IanDeBom/LineFollower/technische tekeningen/mechanisch/readme.md

# mechanische tekening

|bestand|inhoud|
|---|---|
|[SolidworksDrawing_Linefollower.pdf](SolidworksDrawing_Linefollower.pdf)|SolidWorks-tekening van de printomtrek (outline) van de PCB|

De omtrek uit deze tekening is gebruikt als printrand (BoardOutline) van de PCB in EasyEDA Pro.
De vorm is een T: achteraan 66 × 45 mm voor de motoren en de batterij, een smalle nek, en vooraan een sensorbalk van 78 × 20 mm. Totale lengte 100 mm.
