IanDeBom/LineFollower/bill of materials/BOM_Linefollower_1-PCB_PCB_Linefollower_2026-11-09.xlsx

No. | Quantity | Comment | Designator | Footprint | Value | Manufacturer Part | Manufacturer | Supplier Part | Supplier | LCSC Price
1 | 6 | 10uF | C1,C2,C4,C9,C12,C24 | C0805 |  | CL21A106KAYNNNE | SAMSUNG(三星) | C15850 | LCSC
2 | 13 | 100nF | C3,C5,C8,C11,C13,C14,C17,C19,C20,C21,C22,C23,C25 | C0805 |  | CC0805KRX7R9BB104 | YAGEO(国巨) | C49678 | LCSC
3 | 1 | 470uF | C6 | CAP-SMD_BD8.0-L8.3-W8.3-LS9.0-FD_RVT25V470M8X10 |  | RVT25V470M8X10 | JIERR(捷而瑞) | C47023111 | LCSC
4 | 1 | 10nF | C7 | C0805 |  | CL21B103KBANNNC | SAMSUNG(三星) | C1710 | LCSC
5 | 1 | 2.2uF | C10 | C0805 |  | CGA0805X7R225M500MT | HRE(芯声) | C23692980 | LCSC
6 | 2 | 12pF | C15,C16 | C0603 |  | CL10C120JB8NNNC | SAMSUNG(三星) | C38523 | LCSC
7 | 1 | 1uF | C18 | C0805 |  | CSA0805X7R105K500KT | HRE(芯声) | C49420273 | LCSC
8 | 1 | XY-IDC2.54-2*3P-W | CN1 | CONN-TH_XY-IDC2.54-2X3P-W |  | XY-IDC2.54-2*3P-W | XYECONN(辛译) | C53200830 | LCSC
9 | 2 | SS34_C8678 | D1,D2 | SMA_L4.3-W2.6-LS5.2-RD |  | SS34 | MDD(辰达半导体) | C8678 | LCSC
10 | 1 | 0805G (Green) | LED1 | LED0805-R-RD |  | KT-0805G | KENTO | C2297 | LCSC
11 | 1 | AO3400A | Q1 | SOT-23-3_L2.9-W1.3-P1.90-LS2.4-BR |  | AO3400A | AOS | C20917 | LCSC
12 | 2 | 22Ω | R1,R2 | R0805 |  | 0805W8F220JT5E | UNI-ROYAL(厚声) | C17561 | LCSC
13 | 2 | 1kΩ | R3,R20 | R0805 |  | 0805W8F1001T5E | UNI-ROYAL(厚声) | C17513 | LCSC
14 | 12 | 10kΩ | R4,R5,R6,R7,R8,R9,R10,R11,R19,R22,R23,R24 | R0805 |  | 0805W8F1002T5E | UNI-ROYAL(厚声) | C17414 | LCSC
15 | 4 | 150Ω | R12,R13,R14,R15 | R0805 |  | 0805W8F1500T5E | UNI-ROYAL(厚声) | C17471 | LCSC
16 | 1 | 100Ω | R16 | R0805 |  | 0805W8F1000T5E | UNI-ROYAL(厚声) | C17408 | LCSC
17 | 4 | 100kΩ | R17,R18,R25,R26 | R0805 |  | 0805W8F1003T5E | UNI-ROYAL(厚声) | C149504 | LCSC
18 | 1 | 2kΩ | R21 | R0805 |  | 0805W8F2001T5E | UNI-ROYAL(厚声) | C17604 | LCSC
19 | 8 | QRE1113GR | S1,S2,S3,S4,S5,S6,S7,S8 | OPTO-SMD_QRE1113GR |  | QRE1113GR | onsemi(安森美) | C232862 | LCSC
20 | 1 | SMTS-102-C4B-N0 | SW1 | SW-TH_SMTS-102-C4B-N0 |  | SMTS-102-C4B-N0 | YUEN FUNG(源丰) | C48393108 | LCSC
21 | 2 | SKPRAAE010 | SW2,SW3 | SW-SMD_SKPRAAE010 |  | SKPRAAE010 | ALPSALPINE(阿尔卑斯阿尔派) | C127484 | LCSC
22 | 1 | V+ | TP1 | TESTPOINT-TH_BD3.2 |  | TP-橘色测试点 | null | C9900007421 | LCSC
23 | 1 | V- | TP2 | TESTPOINT-TH_BD3.2 |  | TP-橘色测试点 | null | C9900007421 | LCSC
24 | 1 | AOUT1 | TP3 | TESTPOINT-TH_BD3.2 |  | TP-橘色测试点 | null | C9900007421 | LCSC
25 | 1 | AOUT2 | TP4 | TESTPOINT-TH_BD3.2 |  | TP-橘色测试点 | null | C9900007421 | LCSC
26 | 1 | BOUT1 | TP5 | TESTPOINT-TH_BD3.2 |  | TP-橘色测试点 | null | C9900007421 | LCSC
27 | 1 | BOUT2 | TP6 | TESTPOINT-TH_BD3.2 |  | TP-橘色测试点 | null | C9900007421 | LCSC
28 | 1 | PM2.54-1X6PZZ-H8.5 | U1 | HDR-TH_PM2.54-1X6PZZ-H8.5 |  | PM2.54-1x6PZZ-H8.5 | SHOU HAN(首韩) | C54876728 | LCSC
29 | 1 | AMS1117-5.0_C165483 | U3 | SOT-223_L6.5-W3.5-P2.30-LS7.0-BR |  | SK1117-5.0 | SHIKUES(时科) | C165483 | LCSC
30 | 1 | DRV8833PWP | U5 | TSSOP-16_L5.0-W4.4-P0.65-LS6.4-BL-EP |  | DRV8833PWPR | TI(德州仪器) | C50506 | LCSC
31 | 1 | ATMEGA32U4-AU | U7 | QFP-44_L10.0-W10.0-P0.80-LS13.2-BL |  | ATMEGA32U4-AU | MICROCHIP(美国微芯) | C44854 | LCSC
32 | 1 | Micro USB-B 5P-Female-SMT_C40940 | USB1 | MICRO-USB-SMD_5P-P0.65-H-M_MICRO-5P |  | 920-F62A2021S10103 | 精拓金 | C40940 | LCSC
33 | 1 | 16MHz | X2 | CRYSTAL-SMD_4P-L3.2-W2.5-BL |  | X322516MLB4SI | YXC(扬兴晶振) | C13738 | LCSC
