IanDeBom/LineFollower/technische tekeningen/elektronisch/EasyEda_ElektrischSchema_Linefollower.pdf

### GND

### Batterij soldeerpads

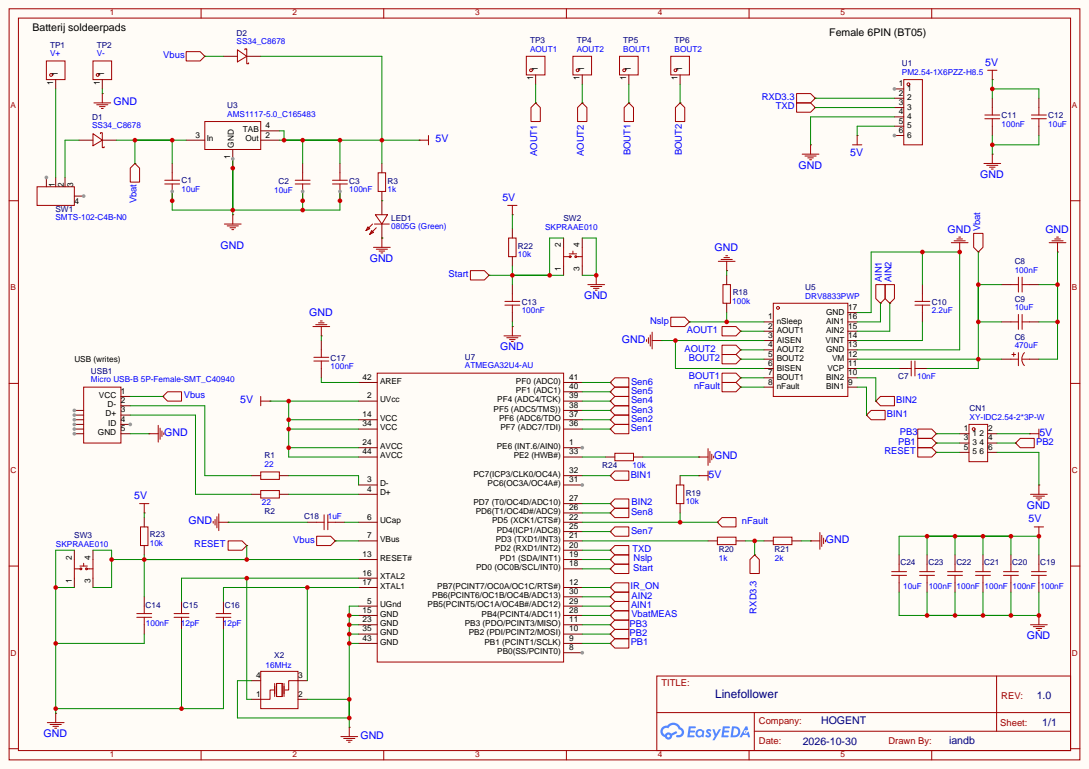
[picture p2: page 1]

AIN1
BIN2 10 VCP 11 VM 12 GND 13 VINT 14 AIN2 15 AIN1 16 GND 17

PB7(PCINT7/OC0A/OC1C/RTS#) 12
PB2 (PDI/PCINT2/MOSI) 10 PB3 (PDO/PCINT3/MISO) 11 PB4(PCINT4/ADC11) 28 PB5(PCINT5/OC1A/OC4B#/ADC12) 29 PB6(PCINT6/OC1B/OC4B/ADC13) 30

GND 5V | GND 5V | GND 5V | GND 5V | GND 5V | GND 5V | GND 5V | GND 5V

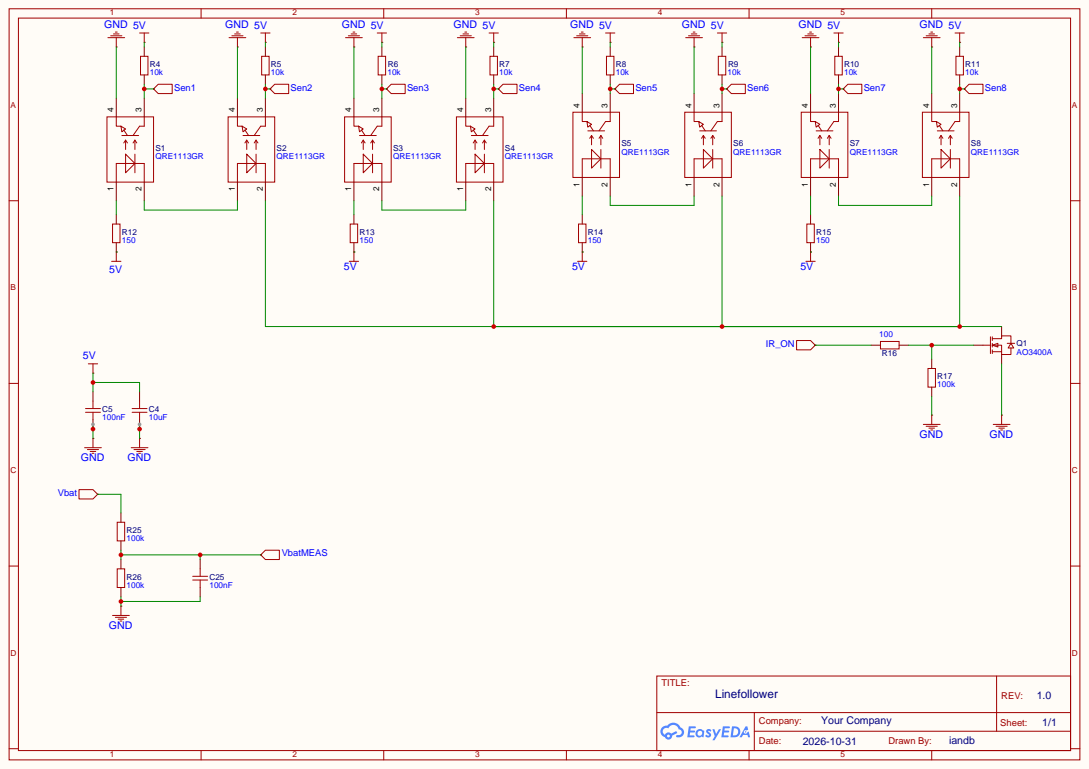
[picture p3: page 2]
