IanDeBom/LineFollower/technische tekeningen/mechanisch/SolidworksDrawing_Linefollower.pdf

D D

6

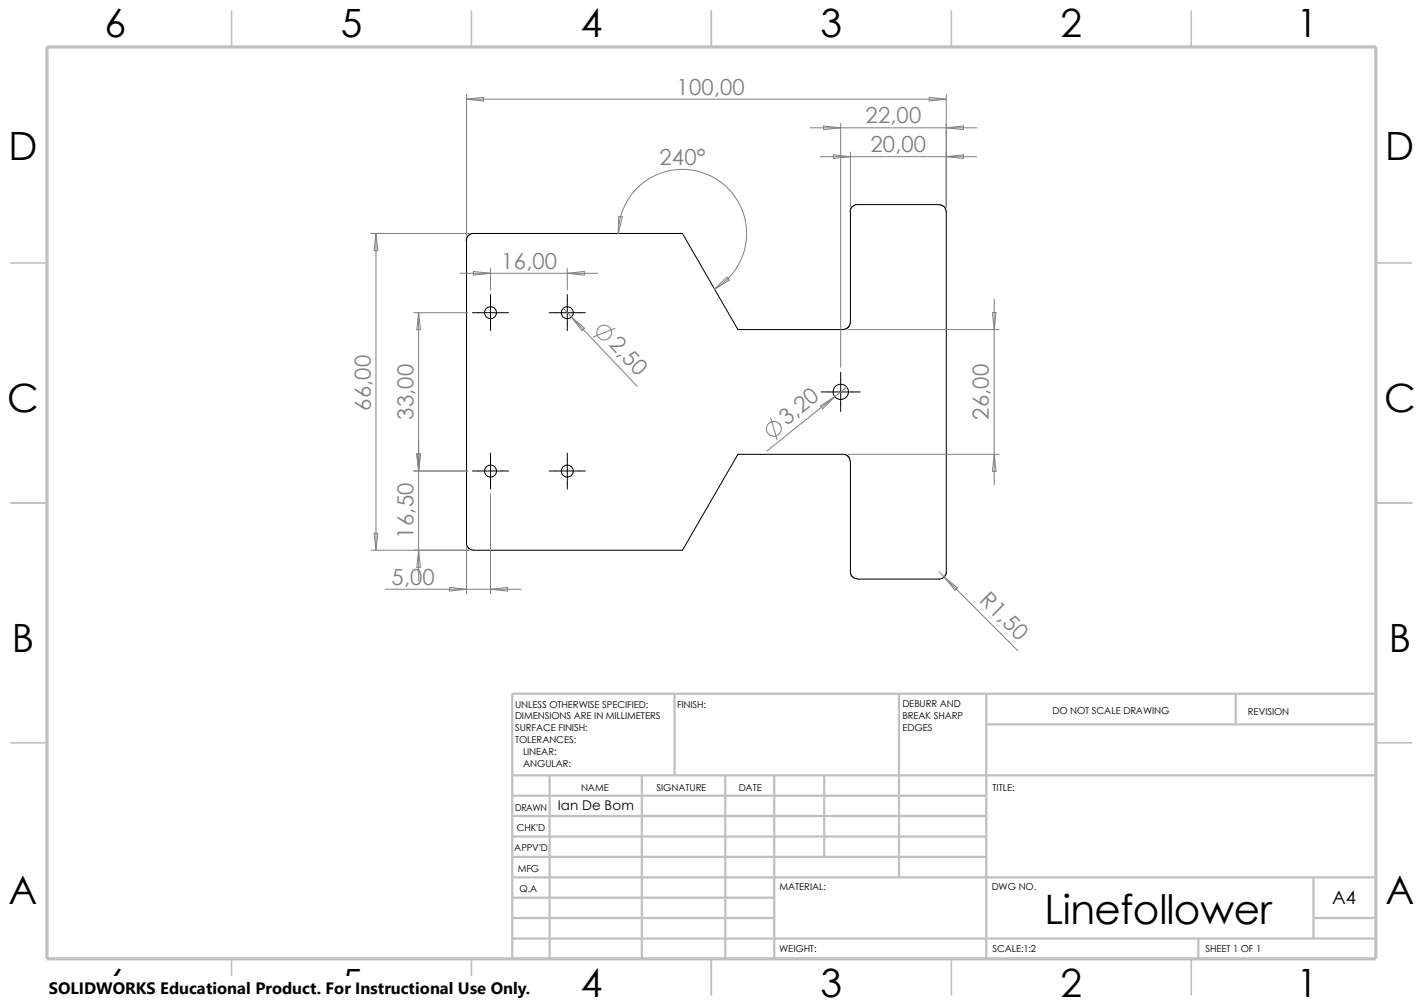
[picture p4: page 1]
SCALE:1:2; SHEET 1 OF 1; WEIGHT:; DO NOT SCALE DRAWING; REVISION; FINISH:; EDGES; DEBURR AND BREAK SHARP

UNLESS OTHERWISE SPECIFIED:
DIMENSIONS ARE IN MILLIMETERS
SURFACE FINISH:
TOLERANCES:
LINEAR:
ANGULAR:

NAME | SIGNATURE | DATE | | | | TITLE:

DRAWN | Ian De Bom

CHK'D
APPV'D

MFG
Q.A | | | | MATERIAL: | DWG NO. Linefollower | A4

SOLIDWORKS Educational Product. For Instructional Use Only.
