IanDeBom/LineFollower/code/basis/programma.ino

#include <Arduino.h>         // basisfuncties Arduino (ATmega328P - Arduino Nano)
#include <EEPROM.h>          // parameters opslaan in eeprom geheugen (ingebouwd)
#include <SoftwareSerial.h>  // seriële verbinding met de BT05 bluetooth (BLE) module (ingebouwd)
#include <SerialCommands.h>  // instelbare parameters via seriële commando's (library "SerialCommands" by Pedro Pereira)

void setup()
{

}

void loop()
{

}
