IanDeBom/LineFollower/(commit log)

2026-09-28 Eerste versie BOM: algemene componenten vastgelegd
    Overzicht van de basiscomponenten van de linefollower:
    - Arduino Nano, HC-05 bluetooth, DRV8833 motordriver
    - 2x N20 30:1 motoren (incl. toerentalberekening bij 2S voeding)
    - QTR-8A sensor array, silicone wielen
    - 2S Li-Ion batterij 7,4 V 2000 mAh, buck converter 5 V, hoofdschakelaar
    Prijzen zijn voorlopig richtprijzen; in volgende versies worden de
    effectieve prijzen en aantallen verder uitgewerkt.
2026-09-28 Prijsaanvulling
    Effectieve aankoopprijzen per component ingevuld en totaal herberekend (€ 49,92).
2026-09-28 Goedkopere QTR-8A sensor
    Prijs QTR-8A aangepast naar € 12,59; totaal herberekend (€ 48,27).
2026-10-26 Datasheets toegevoegd en BOM bijgewerkt naar BT05
    Datasheets van Arduino Nano, DRV8833, QTR-8A, QRE1113, HM-10 en CC2541 toegevoegd, met specificaties van de BT05, de DRV8833-module en de buck converter. HC-05 vervangen door BT05 (BLE) in de BOM.
2026-10-26 Prototype aansluitschema Arduino Nano
    Pinverdeling van alle componenten op de Arduino Nano met grafisch aansluitschema (pinout.svg) in technische tekeningen/elektronisch prototype.
2026-10-26 Basisprogramma met includes en VS Code configuratie
    programma.ino met de includes voor de Arduino Nano en c_cpp_properties.json zodat IntelliSense de Arduino-bestanden vindt.
2026-10-26 Proof of concept draadloze communicatie (BT05)
    Led op D4 aan/uit schakelen via BLE vanaf de iPhone (LightBlue), met aansluitschema en uitleg.
2026-10-26 Proof of concept start/stop interrupt
    Drukknop op D2 (INT0) schakelt de status-led direct om, ook tijdens een blokkerende taak. Met aansluitschema en uitleg.
2026-10-26 Proof of concept motorsturing (DRV8833)
    2 motoren gesimuleerd met leds: onafhankelijk, traploos en in beide richtingen. Met demo, seriële commando's, aansluitschema en stappenplan.
2026-10-26 Proof of concept sensoren (QTR-8A)
    8 sensoren ruw uitlezen op A0-A7 en tonen in de seriële monitor/plotter. Met aansluitschema en testtabel.
2026-11-09 BOM en datasheets voor de eigen PCB
    Kostprijsberekening per robot op basis van de EasyEDA BOM-export (LCSC-prijzen) plus mechanische onderdelen. Datasheets van de PCB-componenten (ATmega32U4, DRV8833, AMS1117, SS34, AO3400A, QRE1113, BT05) en verwijderde prototype-onderdelen.
2026-11-09 Elektrisch schema, Gerbers en SolidWorks-tekening toegevoegd
    EasyEDA schema en Gerber-zip in elektronisch, SolidWorks outline-tekening in mechanisch, met readmes. Prototype-readme vermeldt waarom voor een PCB gekozen is.
2026-11-09 Hoofd-readme en proof of concepts bijgewerkt
    Specificaties en inhoudstabel in de hoofd-readme; uitleg over de opbouw van de proof of concepts.
2026-11-09 Testprogramma en finaal programma voor de PCB
    pcb_test: elk onderdeel apart testen (sensoren, IR-leds, motoren, drukknop, batterij, nFault, EEPROM, bluetooth). linefollower: vaste cyclus, differentiële sensormeting, kalibratie, PID, parameters in EEPROM, niet-blokkerende commando's via USB en BT05, start/stop via interrupt of commando. Gebaseerd op het cyclus-programma van de leerkracht; pinnen volgens het elektrisch schema (ATmega32U4, Arduino Leonardo).
2026-11-13 Ontbrekende datasheets toegevoegd
    Tuimelschakelaar SMTS-102-C4B-N0, drukknop SKPRAAE010, N20-motor (specificaties met bron), batterij 2S Li-Ion, Arduino Nano en QTR-8A voor plan B. Readme opgedeeld in plan A en plan B.
2026-11-13 BOM plan A met aankoopprijzen en glijder, BOM plan B toegevoegd
    Plan A: werkelijke prijzen van LCSC en AliExpress, glijder (bout M3 bolkop + moeren), opmerking over 6 V-motoren op 7,4 V. Plan B: BOM van de opstelling met Arduino Nano en breakout boards.
2026-11-13 Volledig schema plan B met voeding
    Schema van de Arduino Nano-opstelling met batterij, schakelaar, buck converter, BT05, DRV8833-module, QTR-8A en drukknop.
2026-11-13 PCB-layout en EasyEDA Pro-bronbestand toegevoegd
    PDF met plaatsing en koperlagen van boven- en onderkant, en het EasyEDA Pro-project (Linefollower_IDB.eprj2).
